MaxonXOXO/Class-D-amp/Schematics & PCB/PCB 2.png

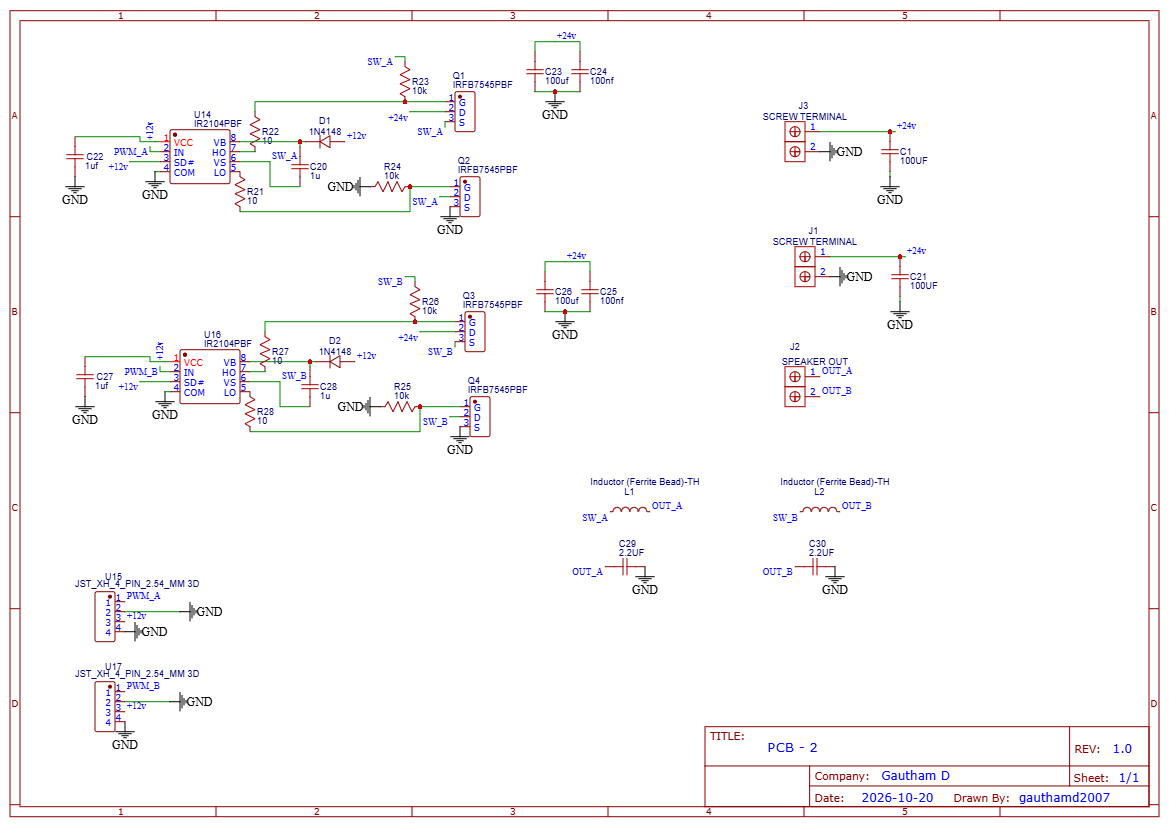
Schematics & PCB/PCB 2.png
