MaxonXOXO/Class-D-amp/Schematics & PCB/PCB-1(2).png

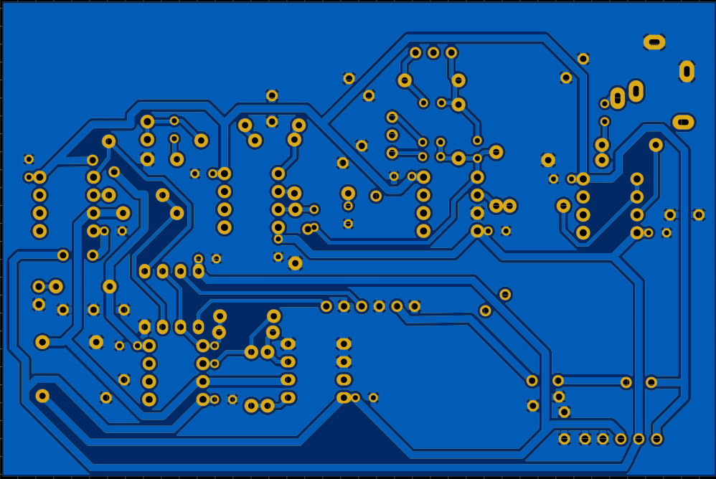
Schematics & PCB/PCB-1(2).png
