MaxonXOXO/Class-D-amp/Schematics & PCB/PCB-1(3).png

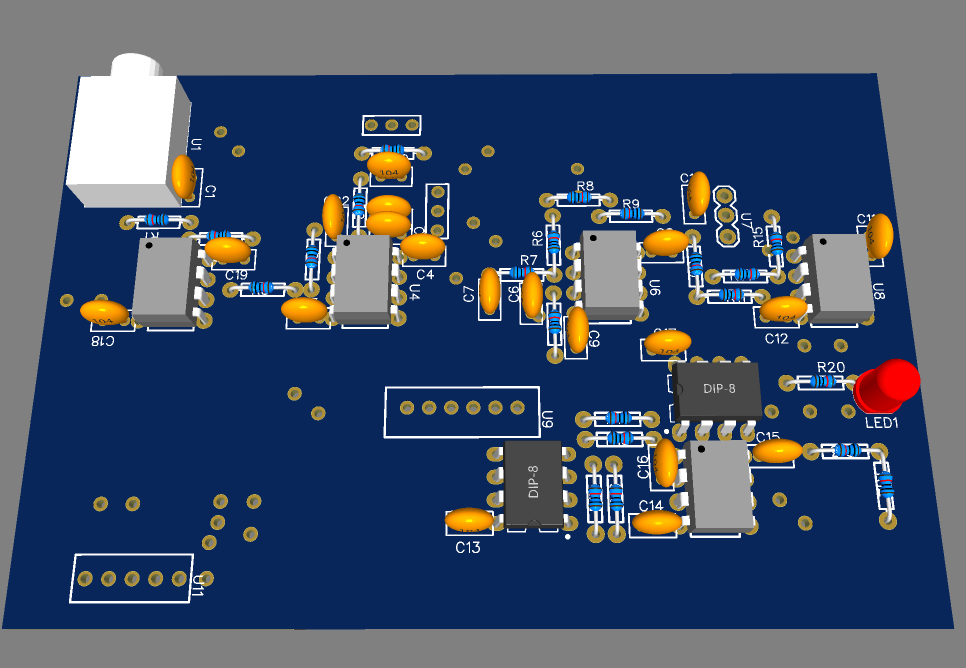
Schematics & PCB/PCB-1(3).png
