MaxonXOXO/Class-D-amp/Schematics & PCB/PCB-1.png

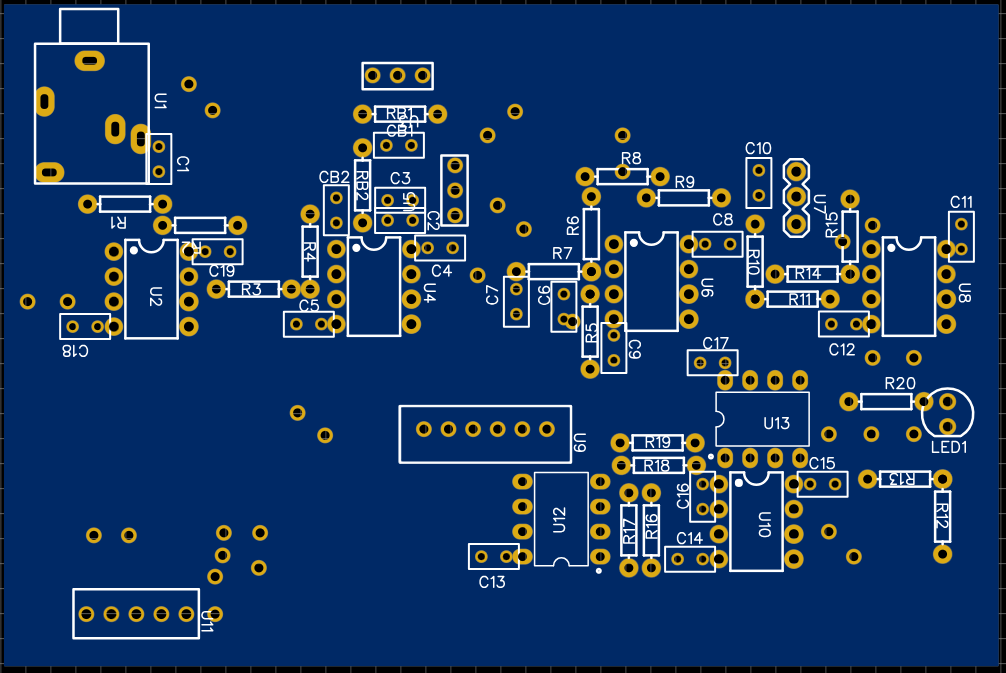
Schematics & PCB/PCB-1.png
