MaxonXOXO/Class-D-amp/Schematics & PCB/PCB-2(3).png

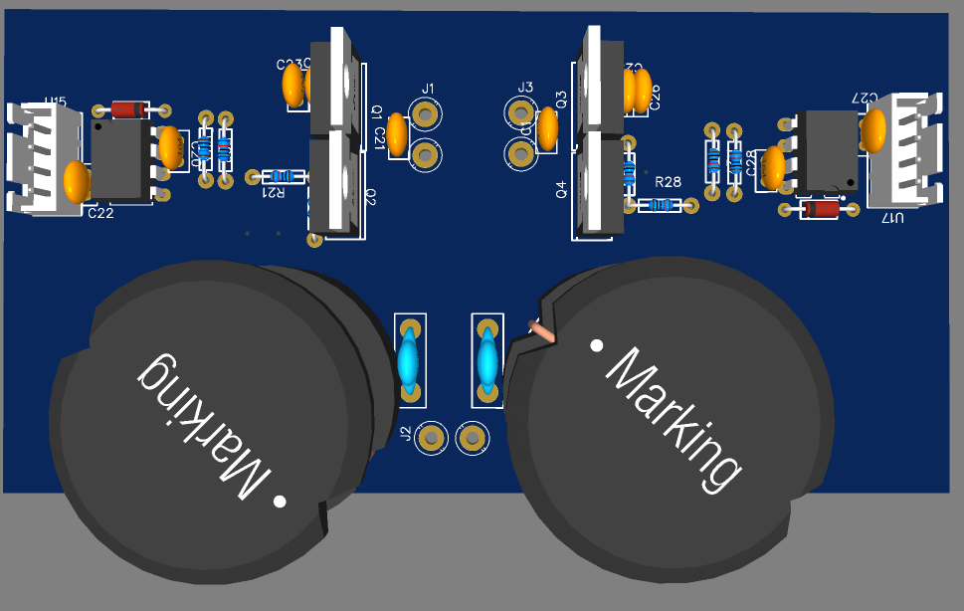
Schematics & PCB/PCB-2(3).png
