MaxonXOXO/Class-D-amp/ltspice_corrected_models/full_amp_10W_final.asc

20k: res; 16k
C1: cap; 2.2µf; V=25
C2: cap; 3.3nF
C3: cap; 3.3nF
C4: cap; 2.2µF
C5: cap; 47µF
C6: cap; 1µf
C7: cap; 100nf
C8: cap; 278pF
C9: cap; 1µf
C10: cap; 1µf
C11: cap; 2.2µf
C12: cap; 2.2µf
C13: cap; 100µf; Rser=20m
C14: cap; 1µf
Cb1: cap; 47n
Cb2: cap; 47n
D1: diode; 1N4148
D2: diode; 1N4148
L1: ind; 18µh; Rser=10m Rpar=5k
L2: ind; 18µh; Rser=10m Rpar=5k
R1: res; 100; tol=1 pwr=0.125
R2: res; 47k; tol=1 pwr=0.125
R3: res; 33k
R4: res; 33k
R5: res; 8.2k
R6: res; 33k
R7: res; 90k
R8: res; 10k
R9: res; 13k
R10: res; 8k
R12: res; 13k
R15: res; 10k
R16: res; 10k
R17: res; 12.5k
R18: res; 15k
R19: res; 10k
R20: res; 100k
R21: res; 100k
R22: res; 10k
R23: res; 10k
R24: res; 10k
R25: res; 10k
R26: res; 10
R27: res; 10
R28: res; 10
R29: res; 10
R30: res; 4
R31: res; 10Meg
R32: res; 100k
Rb1: res; 50k
Rb2: res; 50k
RT1: res; 50k
RT2: res; 50k
U1: NE5532
U2: NE5532
U3: NE5532
U4: TLV3501
U5: NE5532
U6: NE5532
U7: TLV3501
U8: TLV3501
U9: IR2104_BEH
U10: IR2104_BEH
U11: IRFB7545
U12: IRFB7545
U13: IRFB7545
U14: IRFB7545
V1: voltage; SINE(0 0.5 1k)
V2: voltage; 12
V3: voltage; -12
V4: voltage; 5v
V5: voltage; 12v; Rser=10m
V6: voltage; 24V; Rser=10m
Named nets: AUDIO_BIASED, VREF2V5, 0, BASS_B, BASS_A, TONE_SUM, TREBLE_A, TREBLE_B, TREBLE_WIPER, AUDIO_PRE, AUDIO_TONE, GAIN_IN, GAIN_FB, GAIN_REF, AUDIO_GAIN, VOL_TOP, VOL_WIPER, SCALE_IN, VLOGIC5, SCH_P, SQ, TRIANGLE, +12V, -12V, INT_N, AUDIO_INV, PWM_A, PWM_B, 12gate, SW_A, SW_B, +24V, HO1, LO1, HO2, LO2, OUT_A, OUT_B
.include NE5532.lib
 
.include IR2104_LTspice_beh.lib
 
.include irfb7545pbf.spi
 
.include tlv3501.lib
B1 OUT_DIFF 0 V=V(OUT_A)-V(OUT_B)
.tran 0 10m 0 20n startup
.options method=gear gmin=1e-9 abstol=1e-9 reltol=0.003 trtol=7
.ic V(VREF2V5)=2.5 V(TRIANGLE)=2.5 V(SCALE_IN)=2.5 V(AUDIO_BIASED)=2.5
 .save V(SCALE_IN) V(VOL_WIPER) V(AUDIO_INV) V(AUDIO_BIASED) V(TRIANGLE) V(SQ) V(PWM_A) V(PWM_B) V(SW_A) V(SW_B) V(OUT_A) V(OUT_B) V(OUT_DIFF) V(HO1) V(LO1) V(HO2) V(LO2) V(u9:hcmd) V(u10:hcmd) I(V6) I(L1) I(L2)
.four 1k 9 V(OUT_DIFF)
.meas TRAN I_avg AVG I(V6) FROM 8m TO 10m
.meas TRAN Pin AVG -24*I(V6) FROM 8m TO 10m
.meas TRAN Pout AVG V(OUT_DIFF)*V(OUT_DIFF)/4 FROM 8m TO 10m
.meas TRAN Eff PARAM Pout/Pin
