MaxonXOXO/Class-D-amp/(commit log)

2026-10-10 Add full Class-D amplifier schematic and corrected LTspice simulation models
2026-10-10 Add 10W validated Class-D amplifier schematic (full_amp_10W.asc), simulation netlist, harmonic log, and comprehensive documentation
2026-10-11 Update Class-D amplifier documentation, BOM, MIT license, waveform image, and locked final simulation models (full_amp_10W_final)
2026-10-22 Add schematics and PCB design layout exports
2026-10-27 Add PCB Gerber fabrication packages for input and output stages, and update documentation
